AranweLTT/dip-74/images/2d-white.PNG

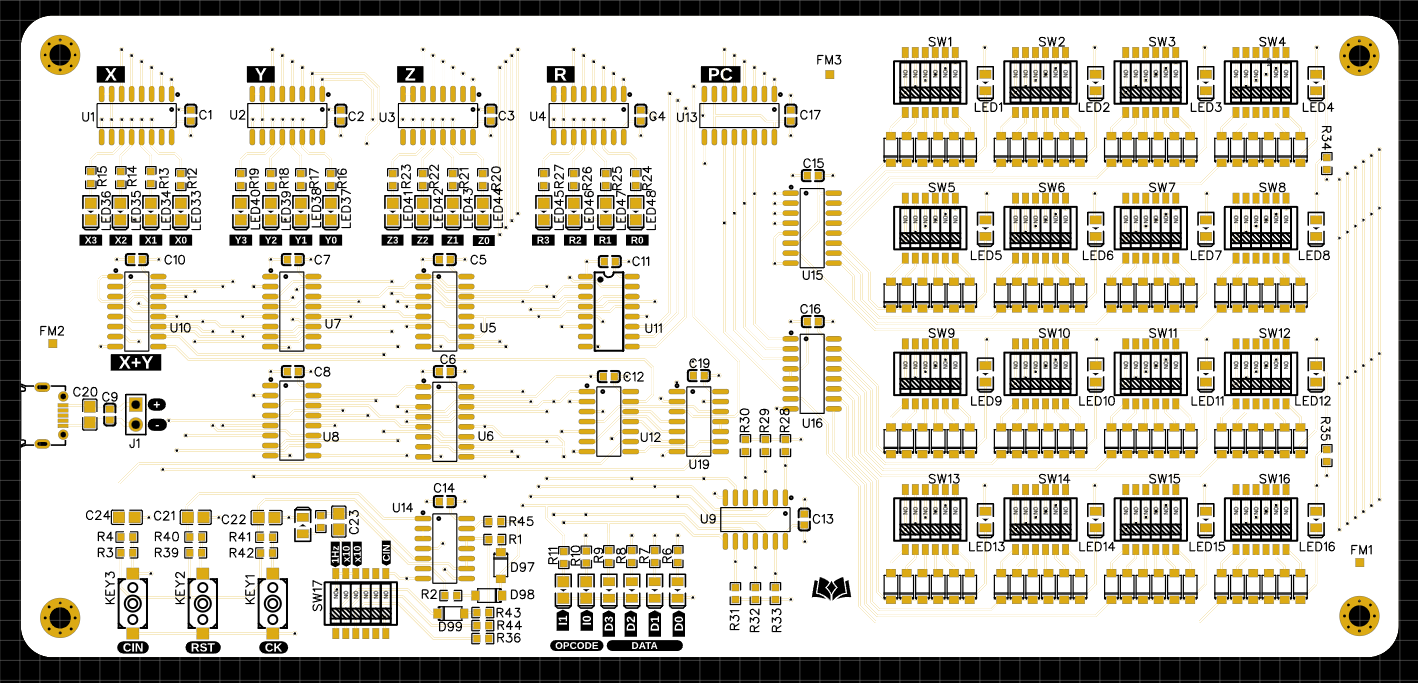
images/2d-white.PNG
