AranweLTT/dip-74/images/architecture.png

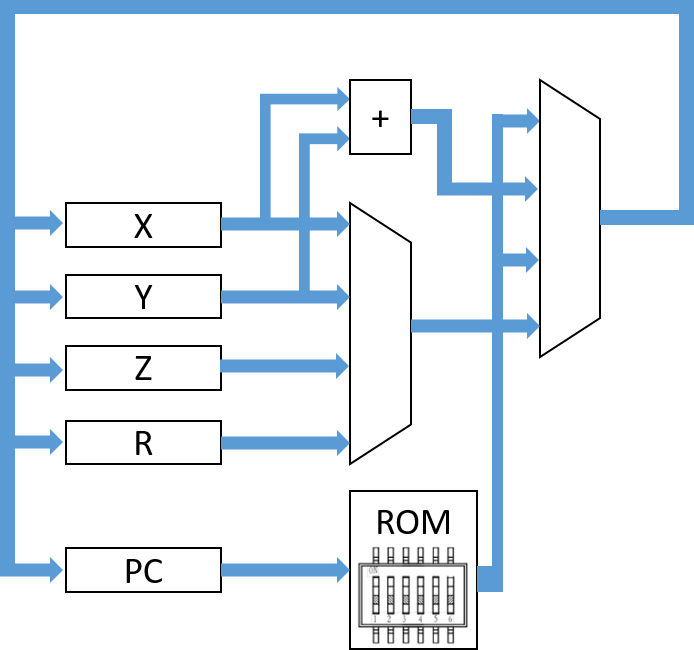
images/architecture.png
