AranweLTT/dip-74/images/dip.png

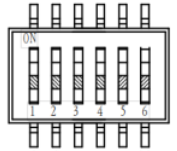
images/dip.png
