AranweLTT/dip-74/simulation/ltspice/simu-clk-2.PNG

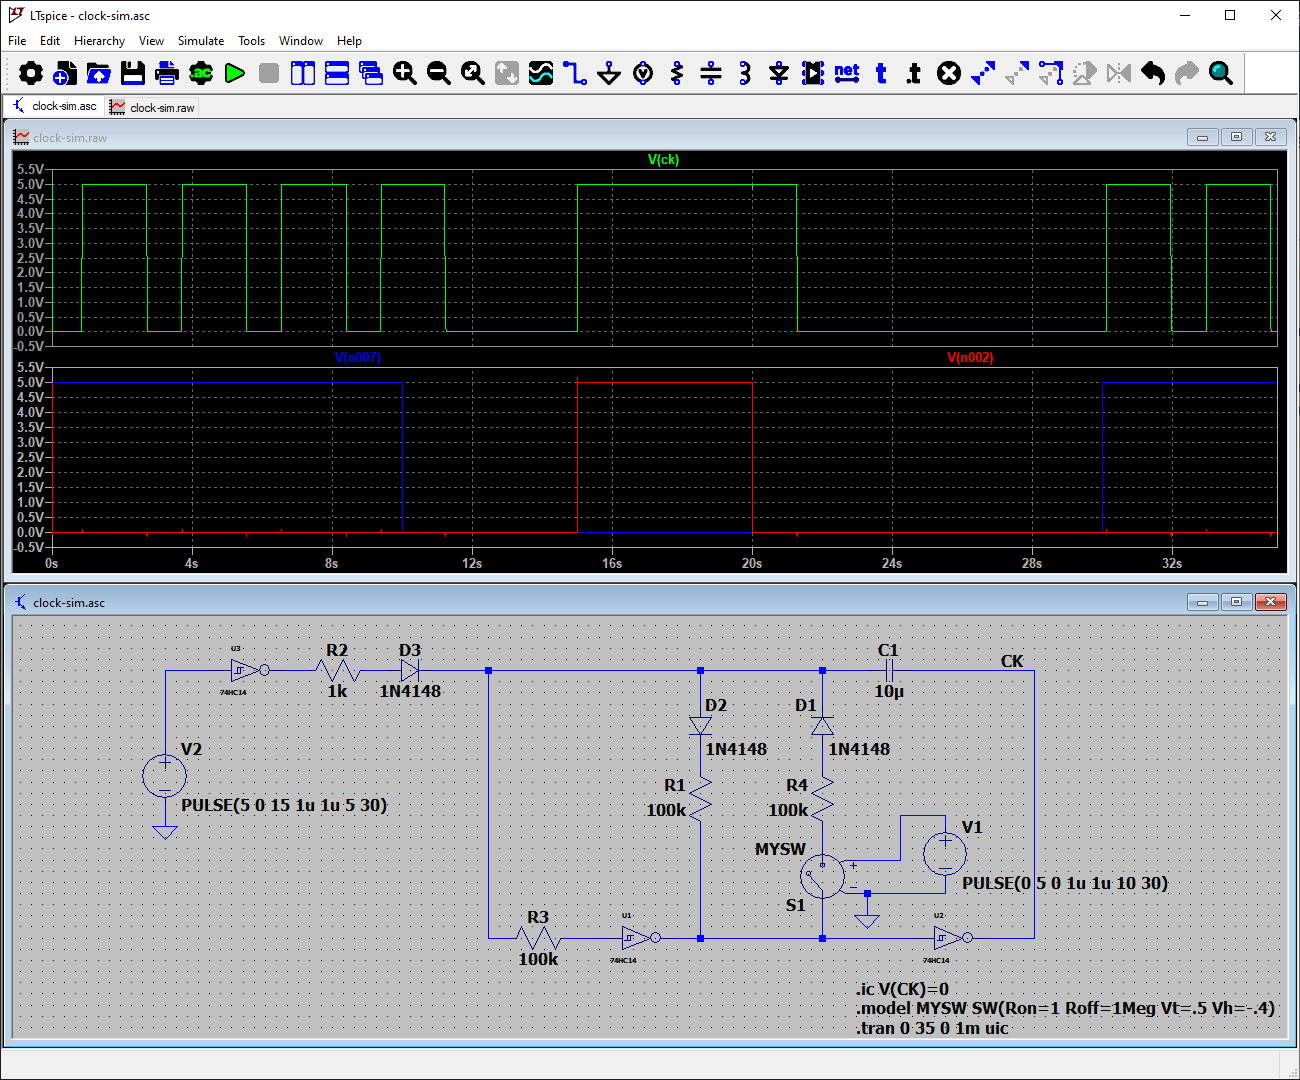
simulation/ltspice/simu-clk-2.PNG
