AranweLTT/dip-74/hardware/BOM_4bit-cpu-light_2025-06-15.csv

ID | Name | Designator | Footprint | Quantity | Manufacturer Part | Manufacturer | Supplier | Supplier Part | Price
1 | 10k | R36,R41,R28,R29,R30,R31,R32,R33,R44,R4 | R0603 | 10
2 | HDR-M-2.54_1x2 | J1 | HDR-M-2.54_1X2 | 1 |  |  | LCSC | C124375 | 0.025
3 | LED-0805_R | LED17,LED1,LED2,LED3,LED4,LED5,LED6,LED7,LED8,LED9,LED10,LED11,LED12,LED13,LED14,LED15,LED16,LED56,LED57,LED58,LED59 | LED0805_RED | 21 | 17-21SURC/S530-A3/TR8 | EVERLIGHT(台湾亿光) |  | C72037 | 0.024
4 | 1k | R5,R6,R7,R8,R9,R10,R11,R12,R13,R14,R15,R16,R17,R18,R19,R20,R21,R22,R23,R24,R25,R26,R27,R39,R42,R2,R3 | R0603 | 27
5 | 100n | C1,C2,C3,C4,C5,C6,C7,C8,C9,C10,C11,C12,C13,C14,C15,C16,C17,C19 | C0603 | 18
6 | 2.2u | C20,C21,C22,C23,C24 | C0805 | 5
7 | 1N4148W-E3-08 | D1,D2,D3,D4,D5,D6,D7,D8,D9,D10,D11,D12,D13,D14,D15,D16,D17,D18,D19,D20,D21,D22,D23,D24,D25,D26,D27,D28,D29,D30,D31,D32,D33,D34,D35,D36,D37,D38,D39,D40,D41,D42,D43,D44,D45,D46,D47,D48,D49,D50,D51,D52,D53,D54,D55,D56,D57,D58,D59,D60,D61,D62,D63,D64,D65,D66,D67,D68,D69,D70,D71,D72,D73,D74,D75,D76,D77,D78,D79,D80,D81,D82,D83,D84,D85,D86,D87,D88,D89,D90,D91,D92,D93,D94,D95,D96,D97,D98,D99 | SOD-123_L2.8-W1.8-LS3.7-RD | 99 | 1N4148W-E3-08 | VISHAY(威世) | LCSC | C241939 | 0.034
8 | K2-3.6×6.1_SMD | KEY1,KEY2,KEY3 | KEY-SMD_2P-L6.2-W3.6-LS8.0 | 3 | K2-1107ST-A4SW-06 |  | LCSC | C118141 | 0.062
9 | LED-0805_B | LED33,LED34,LED35,LED36,LED37,LED38,LED39,LED40,LED41,LED42,LED43,LED44,LED45,LED46,LED47,LED48,LED50,LED51 | LED0805_BLUE | 18 | D-B080508B1-KS2 | 方舟 ARKLED |  | C108412 | 0.019
10 | 2.2k | R34,R35 | R0603 | 2
11 | 100k | R40,R43,R45,R1 | R0603 | 4
12 | SMXMS-06K-TP_WIDE | SW1,SW2,SW3,SW4,SW5,SW6,SW7,SW8,SW9,SW10,SW11,SW12,SW13,SW14,SW15,SW16,SW17 | SW-SMD_12P-L9.2-W5.4-P1.27-LS8.5 | 17 | SMXMS-06K-TP | SM Switch | LCSC | C5439773 | 0.385
13 | SN74HC161DR | U1,U2,U3,U4,U13 | SOIC-16_L9.9-W3.9-P1.27-LS6.0-BL | 5 | SN74HC161DR | TI(德州仪器) | LCSC | C6824 | 0.393
14 | SN74HC153DR | U5,U6,U7,U8 | SOIC-16_L9.9-W3.9-P1.27-LS6.0-BL | 4 | SN74HC153DR | TI(德州仪器) | LCSC | C484751 | 0.237
15 | CD74HC283M96 | U10 | SOIC-16_L9.9-W3.9-P1.27-LS6.0-BL | 1 | CD74HC283M96 | TI(德州仪器) | LCSC | C543032 | 0.589
16 | SN74HC138DR | U15,U16 | SOIC-16_L9.9-W3.9-P1.27-LS6.0-BL | 2 | SN74HC138DR | TI(德州仪器) | LCSC | C6818 | 0.147
17 | SN74HC139DR | U11 | SOIC-16_L10.8-W4.5-P1.27-LS6.8-BL | 1 | SN74HC139DR | TI(德州仪器) | LCSC | C132996 | 0.217
18 | SN74HC14DR | U14,U9,U12 | SOIC-14_L8.7-W3.9-P1.27-LS6.0-BL | 3 | SN74HC14DR | TI(德州仪器) | LCSC | C6820 | 0.094
19 | SN74HC08DR | U19 | SOIC-14_L8.7-W3.9-P1.27-LS6.0-BL | 1 | SN74HC08DR | TI(德州仪器) | LCSC | C337768 | 0.129
20 | USB-Micro_1 | USB1 | MICRO-USB-SMD_5P-P0.65-H-F_C10418 | 1 |  | ValuePro | LCSC | C10418 | 0.072
