AranweLTT/dip-74/hardware/Schematic_4bit-cpu-light_2025-06-15.pdf

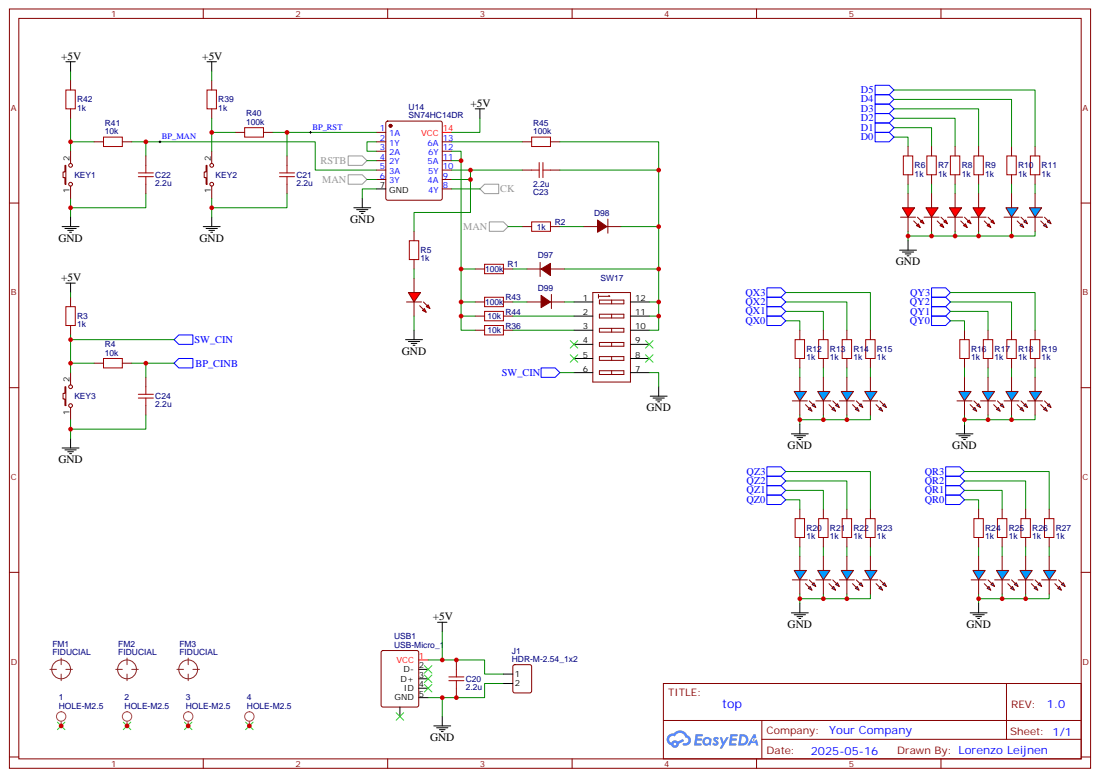
[picture p7: page 1]

Drawn By: Lorenzo Leijnen

# S3 10 B3 11 A3 12 S2 13 A2 14 B2 15 VCC 16

## # 2 to 4 decoder #

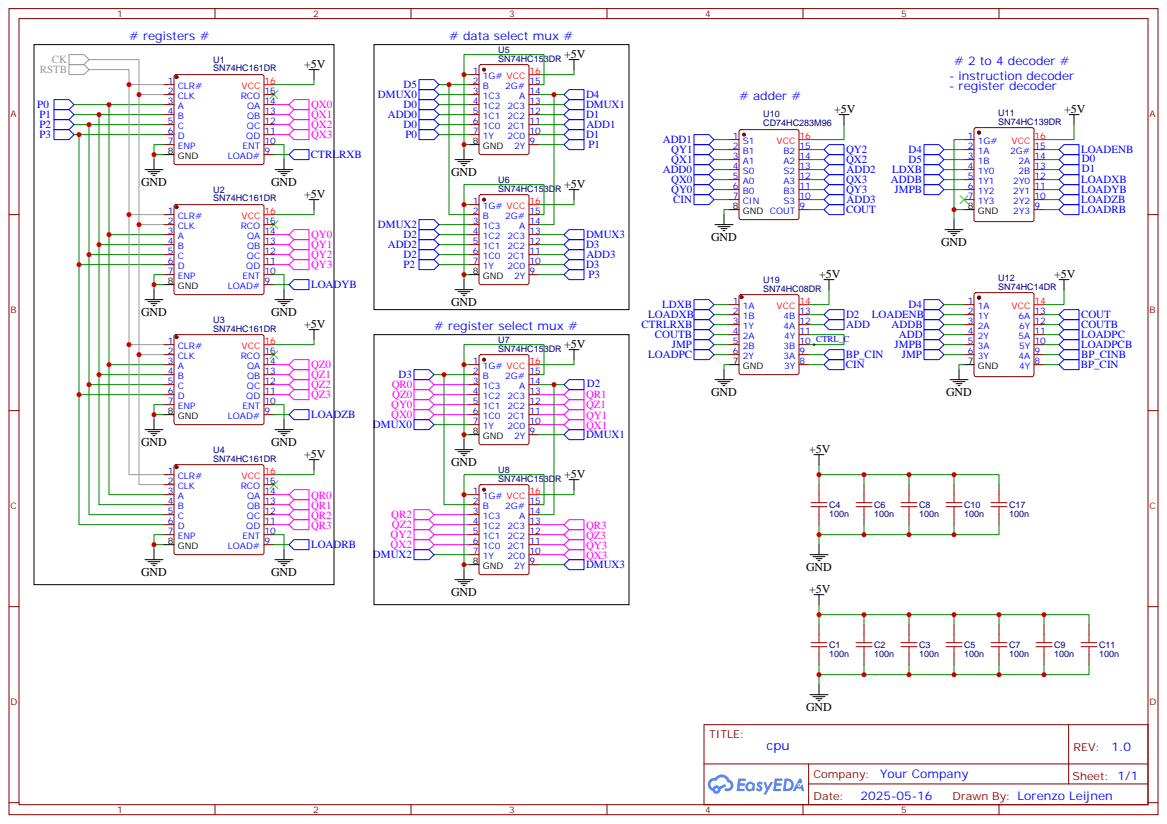
[picture p8: page 2]

ENT 10 QD 11 QC 12 QB 13 QA 14 RCO 15 VCC 16

## # program counter #

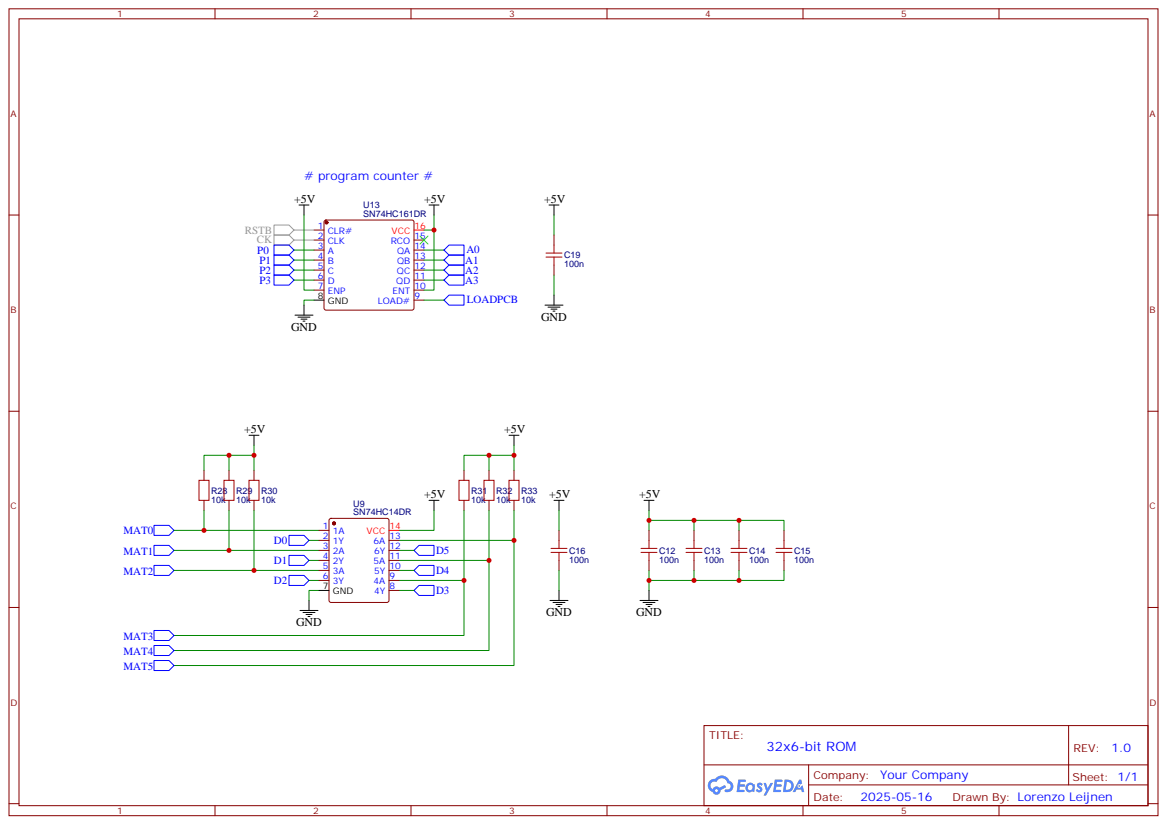
[picture p9: page 3]

ENT 10 QD 11 QC 12 QB 13 QA 14 RCO 15 VCC 16

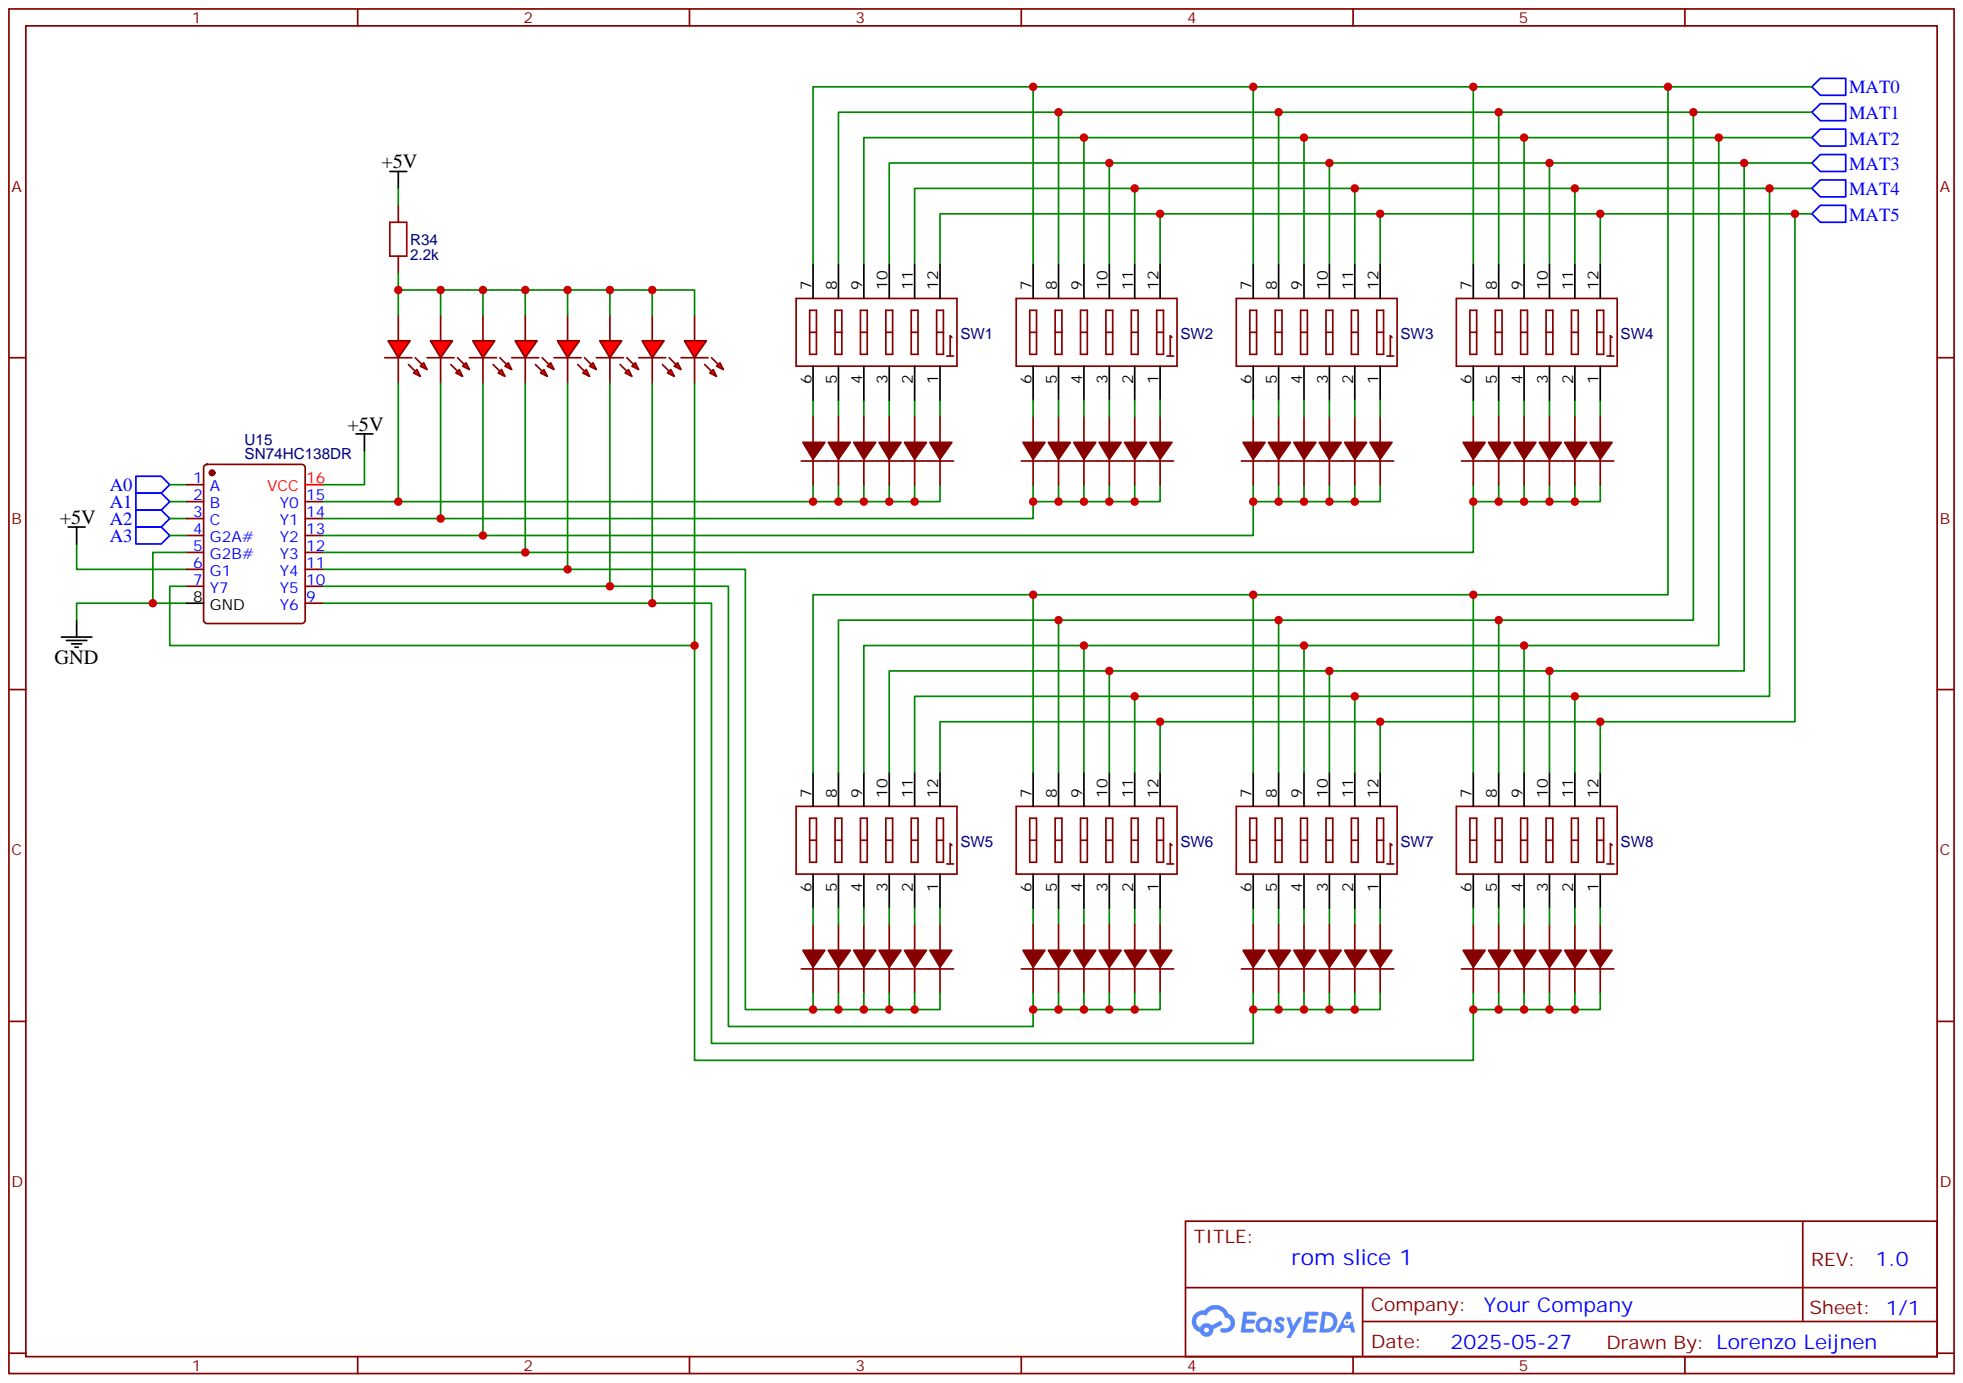
[picture p10: page 4]

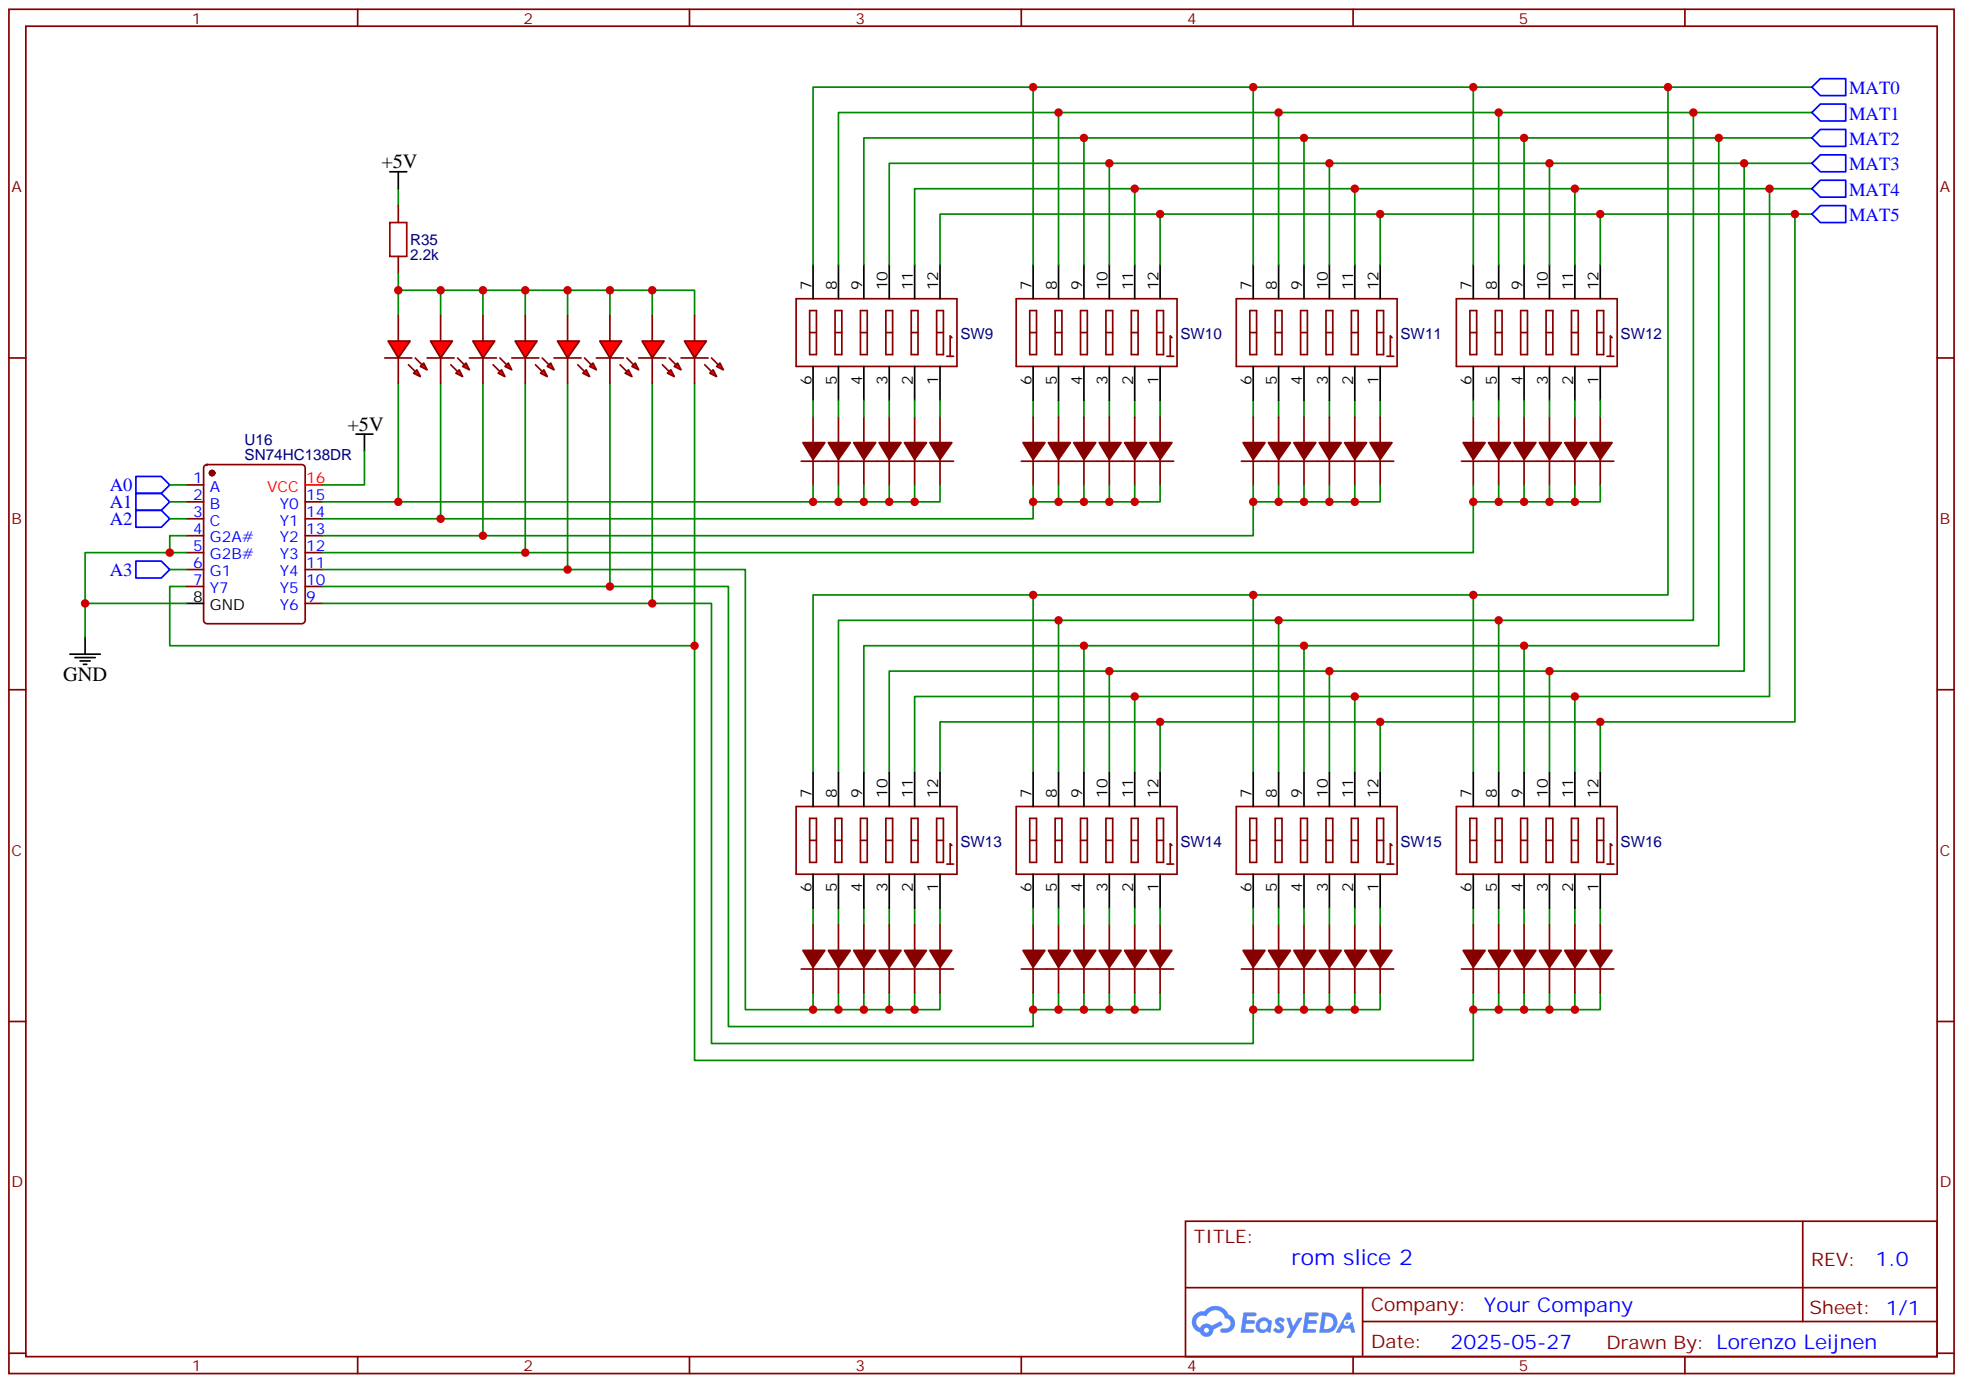
[picture p11: page 5]
