AranweLTT/dip-74/simulation/ltspice/clock-sim.asc

C1: cap; 10µ
D1: diode; 1N4148
D2: diode; 1N4148
D3: diode; 1N4148
R1: res; 100k
R2: res; 1k
R3: res; 100k
R4: res; 100k
S1: sw; MYSW
U1: 74hc14
U2: 74hc14
U3: 74hc14
V1: voltage; PULSE(0 5 0 1u 1u 10 30)
V2: voltage; PULSE(5 0 15 1u 1u 5 30)
Named nets: CK, 0
.tran 0 35 0 1m uic
.ic V(CK)=0
.model MYSW SW(Ron=1 Roff=1Meg Vt=.5 Vh=-.4)
