AranweLTT/dip-74/(list of files, drawings)

Other design files:
simulation/logisim/4bit-cpu-architecture-light.circ
